tdmorton/USBPowerMonitor/USB_Power_Monitor.kicad_pcb

## KiCad design USB_Power_Monitor.kicad_pcb (2026-03-26)

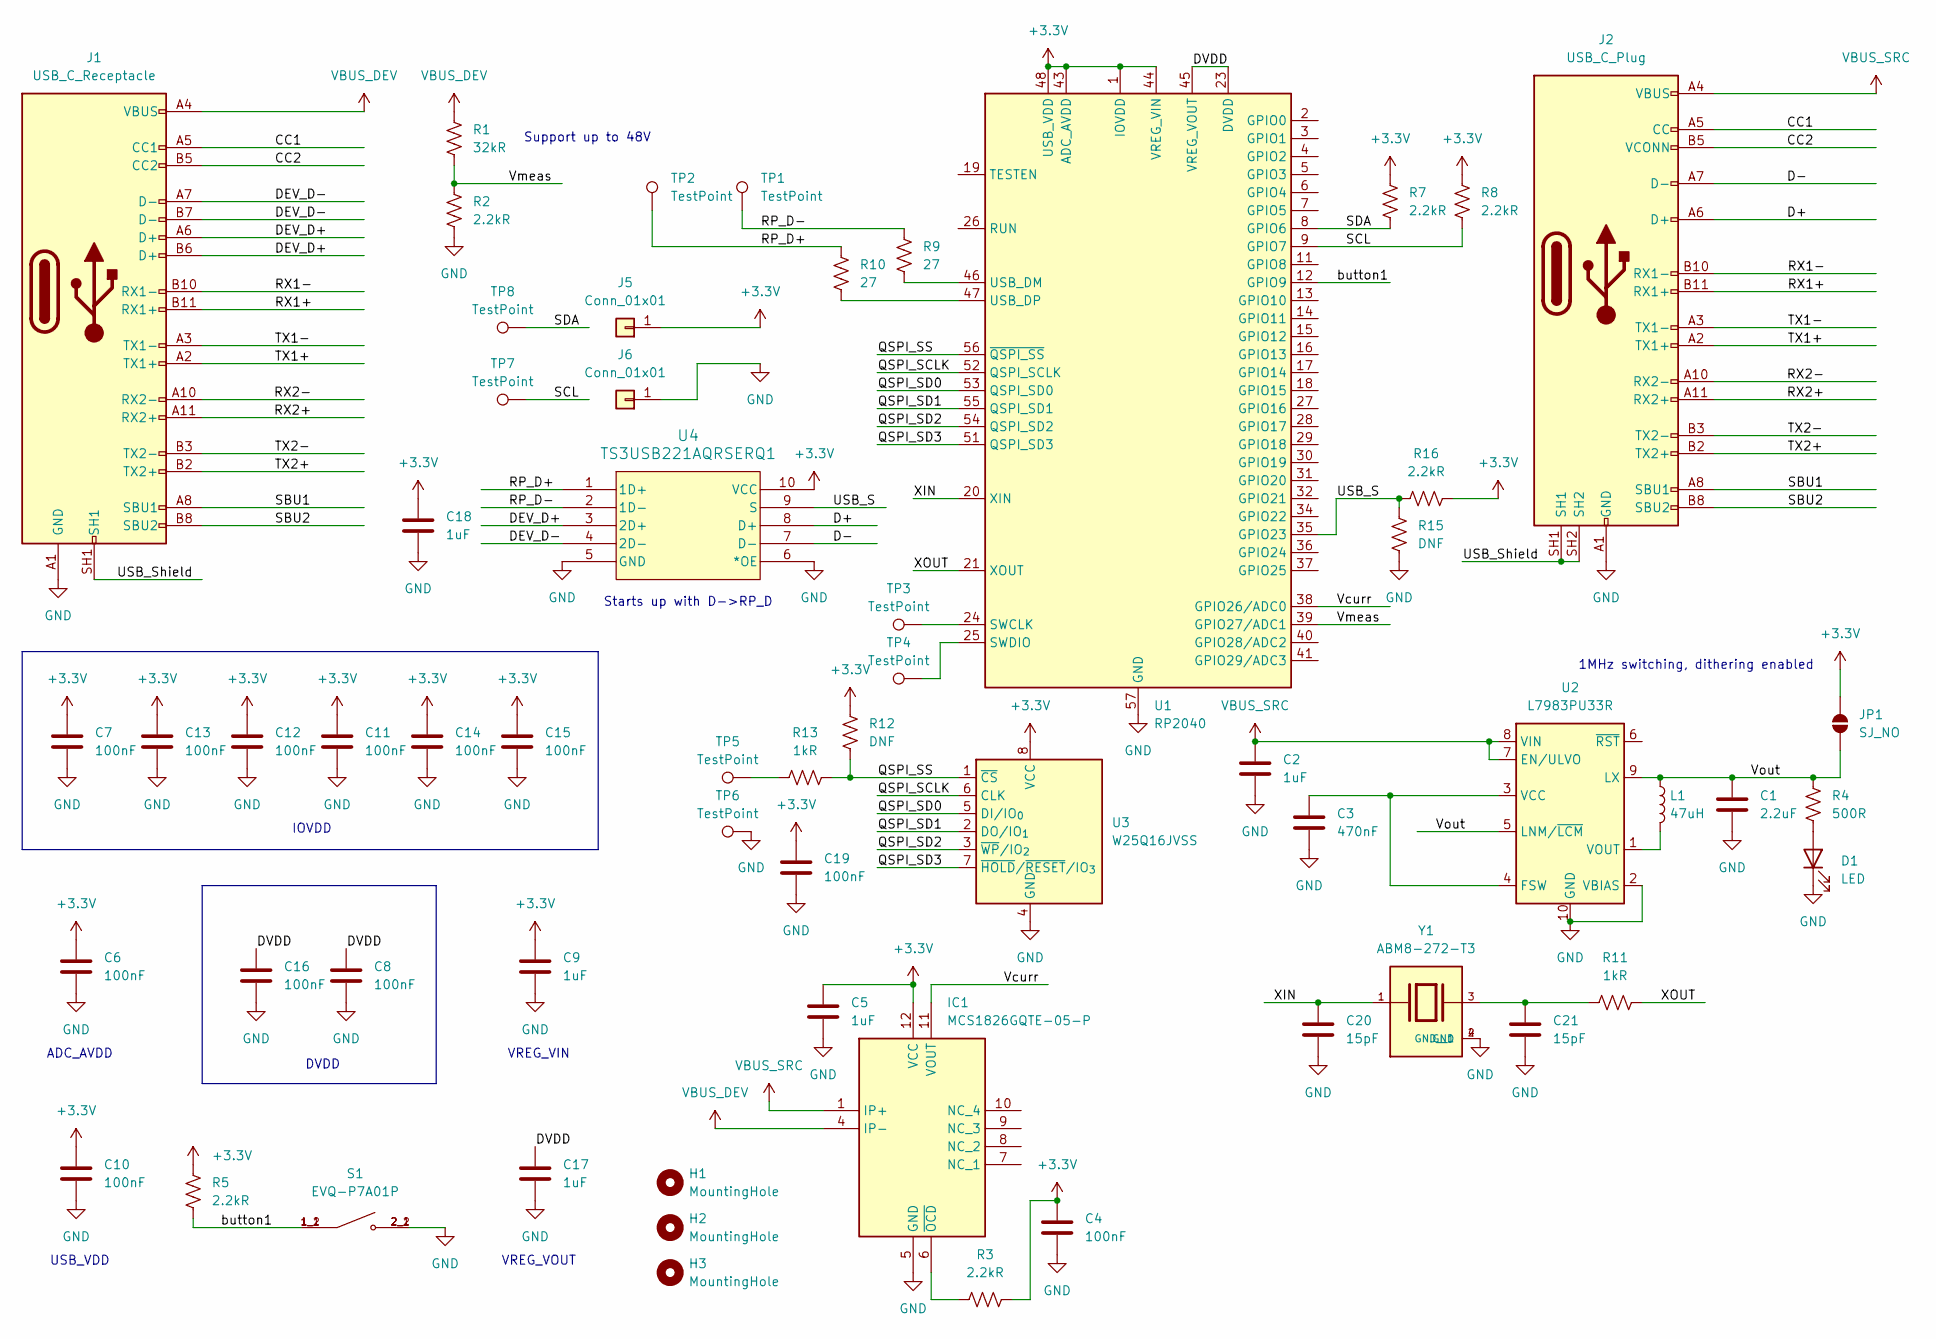
[picture p1: schematic USB_Power_Monitor.kicad_sch, USB Power Monitor]

Parts:
C1: 2.2uF; C_0603_1608Metric; Manufacturer_Part_Number KGM15BR50J225KT; Mouser Part Number 581-KGM15BR50J225KT
C2: 1uF; C_0603_1608Metric; Manufacturer_Part_Number C1608X7R2A105K080AC; Mouser Part Number 810-C1608X7R2A105K08
C3: 470nF; C_0603_1608Metric; Manufacturer_Part_Number GRM188R71E474KA12J; Mouser Part Number 81-GRM188R71E474KA2J
C4, C6, C7, C8, C10, C11, C12, C13, C14, C15, C16, C19: 100nF; C_0603_1608Metric; Manufacturer_Part_Number CC0603ZRY5V8BB104; Mouser Part Number 603-C0603ZRY5V8BB104
C5, C9, C17, C18: 1uF; C_0603_1608Metric; Manufacturer_Part_Number CC0603KRX5R8BB105; Mouser Part Number 603-CC603KRX5R8BB105
C20, C21: 15pF; C_0603_1608Metric; Manufacturer_Part_Number CC0603JRNPO9BN150
D1: LED; C_0603_1608Metric; Manufacturer_Part_Number TLMS1100-GS15; Mouser Part Number 78-TLMS1100-GS15
H1, H2, H3: MountingHole; MountingHole_2.2mm_M2
IC1: MCS1826GQTE-05-P; MCS1826GQTE05P; Mouser Part Number 946-MCS1826GQTE-05-P
J1: USB_C_Receptacle; CONN24_4056-03-A_GCT; Manufacturer_Part_Number USB4056-03-A; Mouser Part Number 640-USB4056-03-A
J2: USB_C_Plug; MOLEX_1054440011; Manufacturer_Part_Number 1054440011; Mouser Part Number 538-105444-0011
J5, J6: Conn_01x01; PinHeader_1x01_P2.54mm_Vertical
JP1: SJ_NO; SolderJumper-2_P1.3mm_Open_RoundedPad1.0x1.5mm
L1: 47uH; L_0805_2012Metric; Manufacturer_Part_Number MLZ2012M470WT000; Mouser Part Number 810-MLZ2012M470WT000
R1: 32kR; C_0603_1608Metric; Manufacturer_Part_Number RC0603FR-0732K4L
R2, R3, R5, R7, R8, R16: 2.2kR; C_0603_1608Metric; Manufacturer_Part_Number RC0603FR-072K2L
R4: 500R; C_0603_1608Metric; Manufacturer_Part_Number RC0603FR-07499RL
R9, R10: 27; C_0603_1608Metric; Manufacturer_Part_Number RC0603FR-0727RL
R11, R13: 1kR; C_0603_1608Metric; Manufacturer_Part_Number RC0603FR-071KL
R12, R15: DNF; C_0603_1608Metric
S1: EVQ-P7A01P; SW_EVQ-P7A01P; PARTREV 2022.4
TP1, TP2, TP3, TP4, TP5, TP6, TP7, TP8: TestPoint; TestPoint_Pad_1.0x1.0mm
U1: RP2040; QFN-56-1EP_7x7mm_P0.4mm_EP3.2x3.2mm; Manufacturer_Part_Number RP2040
U2: L7983PU33R; ST_DFN-10-1EP_3x3mm_P0.5mm_EP0.62x0.98mm; Manufacturer_Part_Number L7983PU33R; Mouser Part Number 511-L7983PU33R
U3: W25Q16JVSS; SOIC-8_5.3x5.3mm_P1.27mm; Manufacturer_Part_Number W25Q16JVSSIQ TR
U4: TS3USB221AQRSERQ1; RSE10; Manufacturer_Part_Number TS3USB221AQRSERQ1
Y1: ABM8-272-T3; XTAL_ABM8-272-T3; PARTREV 07-29-20

Connections:
+3.3V: C4.1, C5.1, C6.1, C7.1, C9.1, C10.1, C11.1, C12.1, C13.1, C14.1, C15.1, C18.1, C19.1, IC1.12 (VCC), J5.1, JP1.2 (B), R3.1, R5.1, R7.1, R8.1, R12.2, R16.2, U1.1 (IOVDD), U1.10 (IOVDD), U1.22 (IOVDD), U1.33 (IOVDD), U1.42 (IOVDD), U1.43 (ADC_AVDD), U1.44 (VREG_VIN), U1.48 (USB_VDD), U1.49 (IOVDD), U3.8 (VCC), U4.10 (VCC)
/CC1: J1.A5 (CC1), J2.A5 (CC)
/CC2: J1.B5 (CC2), J2.B5 (VCONN)
/D+: J2.A6 (D+), U4.8 (D+)
/D-: J2.A7 (D-), U4.7 (D-)
/DEV_D+: J1.A6 (D+), J1.B6 (D+), U4.3 (2D+)
/DEV_D-: J1.A7 (D-), J1.B7 (D-), U4.4 (2D-)
/DVDD: C8.1, C16.1, C17.1, U1.23 (DVDD), U1.45 (VREG_VOUT), U1.50 (DVDD)
/QSPI_SCLK: U1.52 (QSPI_SCLK), U3.6 (CLK)
/QSPI_SD0: U1.53 (QSPI_SD0), U3.5 (DI/IO_{0})
/QSPI_SD1: U1.55 (QSPI_SD1), U3.2 (DO/IO_{1})
/QSPI_SD2: U1.54 (QSPI_SD2), U3.3 (~WP/IO_{2})
/QSPI_SD3: U1.51 (QSPI_SD3), U3.7 (~HOLD/~RESET/IO_{3})
/QSPI_SS: R12.1, R13.2, U1.56 (~QSPI_SS), U3.1 (~CS)
/RP_D+: R10.2, TP2.1, U4.1 (1D+)
/RP_D-: R9.2, TP1.1, U4.2 (1D-)
/RX1+: J1.B11 (RX1+), J2.B11 (RX1+)
/RX1-: J1.B10 (RX1-), J2.B10 (RX1-)
/RX2+: J1.A11 (RX2+), J2.A11 (RX2+)
/RX2-: J1.A10 (RX2-), J2.A10 (RX2-)
/SBU1: J1.A8 (SBU1), J2.A8 (SBU1)
/SBU2: J1.B8 (SBU2), J2.B8 (SBU2)
/SCL: R8.2, TP7.1, U1.9 (GPIO7)
/SDA: R7.2, TP8.1, U1.8 (GPIO6)
/TX1+: J1.A2 (TX1+), J2.A2 (TX1+)
/TX1-: J1.A3 (TX1-), J2.A3 (TX1-)
/TX2+: J1.B2 (TX2+), J2.B2 (TX2+)
/TX2-: J1.B3 (TX2-), J2.B3 (TX2-)
/USB_S: R15.2, R16.1, U1.35 (GPIO23), U4.9 (S)
/USB_Shield: J1.SH1, J1.SH2, J1.SH3, J1.SH4, J2.SH1, J2.SH2
/Vcurr: IC1.11 (VOUT), U1.38 (GPIO26/ADC0)
/Vmeas: R1.2, R2.1, U1.39 (GPIO27/ADC1)
/Vout: C1.1, JP1.1 (A), L1.1, R4.1, U2.5 (LNM/~LCM), U2.9 (LX)
/XIN: C20.1, U1.20 (XIN), Y1.1
/XOUT: R11.2, U1.21 (XOUT)
/button1: R5.2, S1.1_1, S1.1_2, U1.12 (GPIO9)
GND: C1.2, C2.2, C3.2, C4.2, C5.2, C6.2, C7.2, C8.2, C9.2, C10.2, C11.2, C12.2, C13.2, C14.2, C15.2, C16.2, C17.2, C18.2, C19.2, C20.2, C21.2, D1.1 (K), IC1.5 (GND), J1.A1 (GND), J1.A12 (GND), J1.B1 (GND), J1.B12 (GND), J2.A1 (GND), J2.A12 (GND), J2.B1 (GND), J2.B12 (GND), J6.1, R2.2, R15.1, S1.2_1, S1.2_2, TP6.1, U1.57 (GND), U2.2 (VBIAS), U2.10 (GND), U2.11 (GND), U3.4 (GND), U4.5 (GND), U4.6 (*OE), Y1.2 (GND), Y1.4 (GND__1)
unnamed: C21.1, R11.1, Y1.3
unnamed: D1.2 (A), R4.2
unnamed: IC1.6 (~OCD), R3.2
unnamed: R13.1, TP5.1
unnamed: TP3.1, U1.24 (SWCLK)
unnamed: TP4.1, U1.25 (SWDIO)
unnamed: R9.1, U1.46 (USB_DM)
unnamed: R10.1, U1.47 (USB_DP)
unnamed: C3.1, U2.3 (VCC), U2.4 (FSW)
unnamed: L1.2, U2.1 (VOUT)
VBUS_DEV: IC1.4 (IP-), J1.A4 (VBUS), J1.A9 (VBUS), J1.B4 (VBUS), J1.B9 (VBUS), R1.1
VBUS_SRC: C2.1, IC1.1 (IP+), J2.A4 (VBUS), J2.A9 (VBUS), J2.B4 (VBUS), J2.B9 (VBUS), U2.7 (EN/ULVO), U2.8 (VIN)

Notes on the sheet:
USB_VDD
Starts up with D->RP_D
ADC_AVDD
1MHz switching, dithering enabled
VREG_VOUT
VREG_VIN
Support up to 48V
DVDD
IOVDD

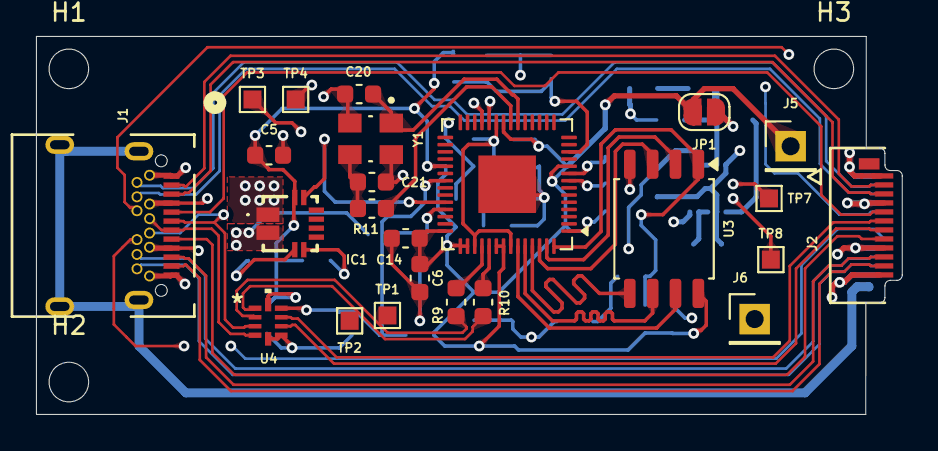
[picture p2: board USB_Power_Monitor.kicad_pcb from above]

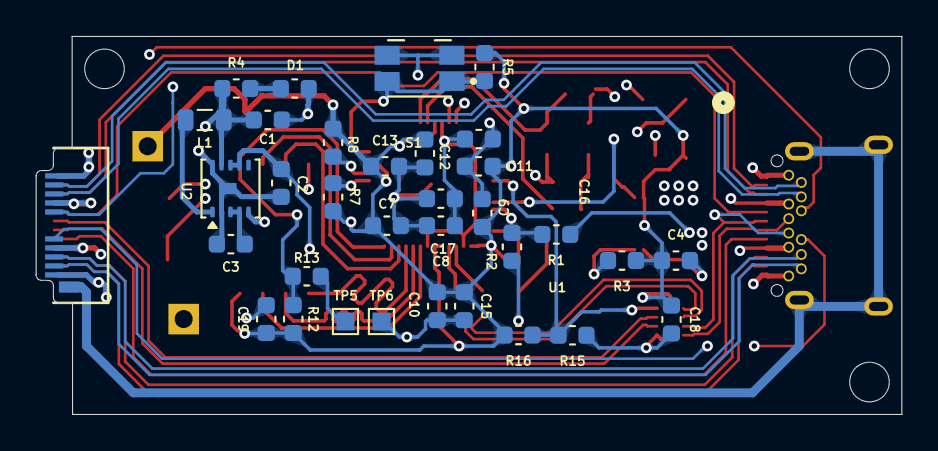
[picture p3: board USB_Power_Monitor.kicad_pcb from below]

Board: 4 copper layers, 48.1 x 21.0 mm, 60 parts (33 on the bottom side), 49 nets.
