tdmorton/USBPowerMonitor/(commit log)

2026-02-23 Adding initial project
    [USB_Power_Monitor.kicad_pcb, USB_Power_Monitor.kicad_sch]
2026-02-26 finished routing RP2040
    [USB_Power_Monitor.kicad_pcb, USB_Power_Monitor.kicad_sch]
2026-03-01 finished routing most components, no power yet
    [USB_Power_Monitor.kicad_pcb, USB_Power_Monitor.kicad_sch]
2026-03-09 Main power zone defined
    [USB_Power_Monitor.kicad_pcb, USB_Power_Monitor.kicad_sch]
2026-03-21 All nets routed, need to clean up text and check errors
    [USB_Power_Monitor.kicad_pcb, USB_Power_Monitor.kicad_sch]
2026-03-21 Fixed overlapping silkscreen
    [USB_Power_Monitor.kicad_pcb]
2026-03-22 All DRC cleared except board outline and some weird footprint issues
    [USB_Power_Monitor.kicad_pcb]
2026-03-22 Add .gitignore, starting fab process
    [USB_Power_Monitor.kicad_pcb]
2026-03-22 Added SWD test points, roughly length matched qspi
    [USB_Power_Monitor.kicad_pcb, USB_Power_Monitor.kicad_sch]
2026-03-23 Increase 3.3V trace width, add teardrops, generate fab files
    [USB_Power_Monitor.kicad_pcb]
2026-03-24 Fix BOM part numbers
    [USB_Power_Monitor.kicad_pcb, USB_Power_Monitor.kicad_sch]
2026-03-26 Fixed GND plane, add mounting holes
    [USB_Power_Monitor.kicad_pcb, USB_Power_Monitor.kicad_sch]
